jtiongco2601/ESP32-Acoustic-Drone-Detector/(commit log)

2026-07-20 ESP32 drone detector firmware
2026-07-20 prototype demonstration video
